billyischilly/hexydeck/Build Pictures/IMG_5169 Large.jpeg

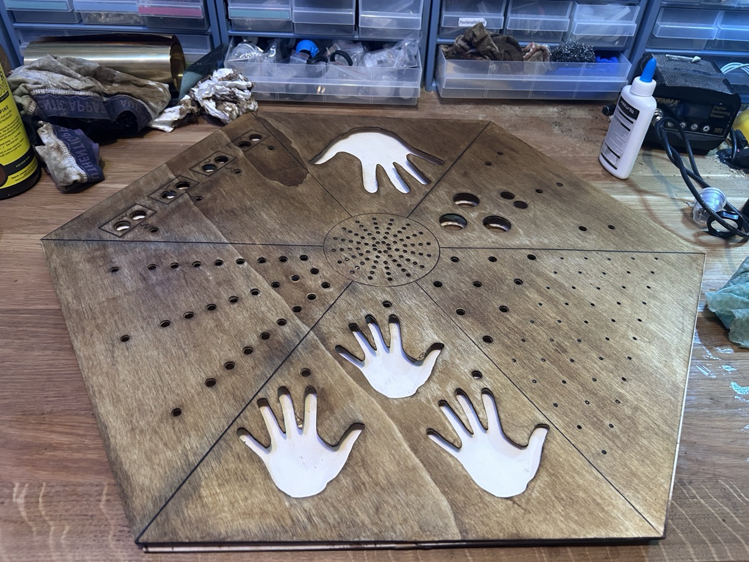
Build Pictures/IMG_5169 Large.jpeg
