billyischilly/hexydeck/Build Pictures/IMG_5170 Large.jpeg

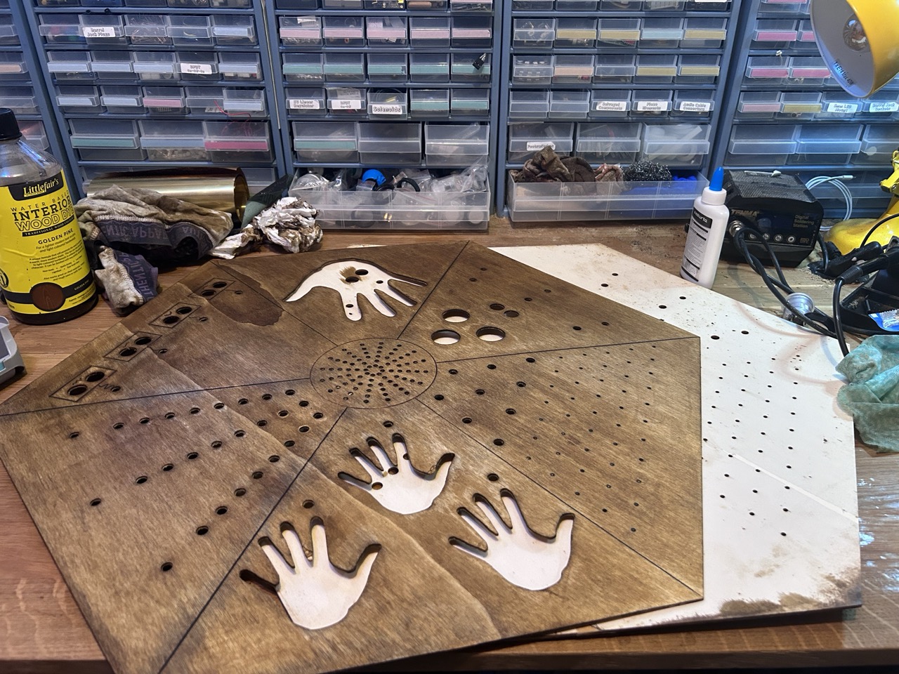
Build Pictures/IMG_5170 Large.jpeg
