billyischilly/hexydeck/Build Pictures/IMG_5171 Large.jpeg

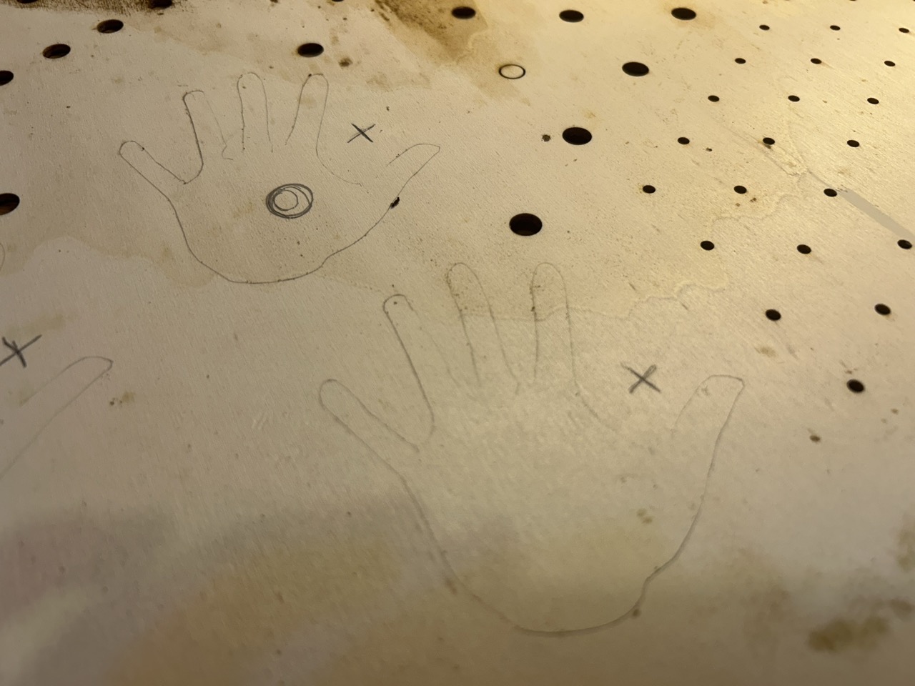
Build Pictures/IMG_5171 Large.jpeg
