billyischilly/hexydeck/Build Pictures/IMG_5172 Large.jpeg

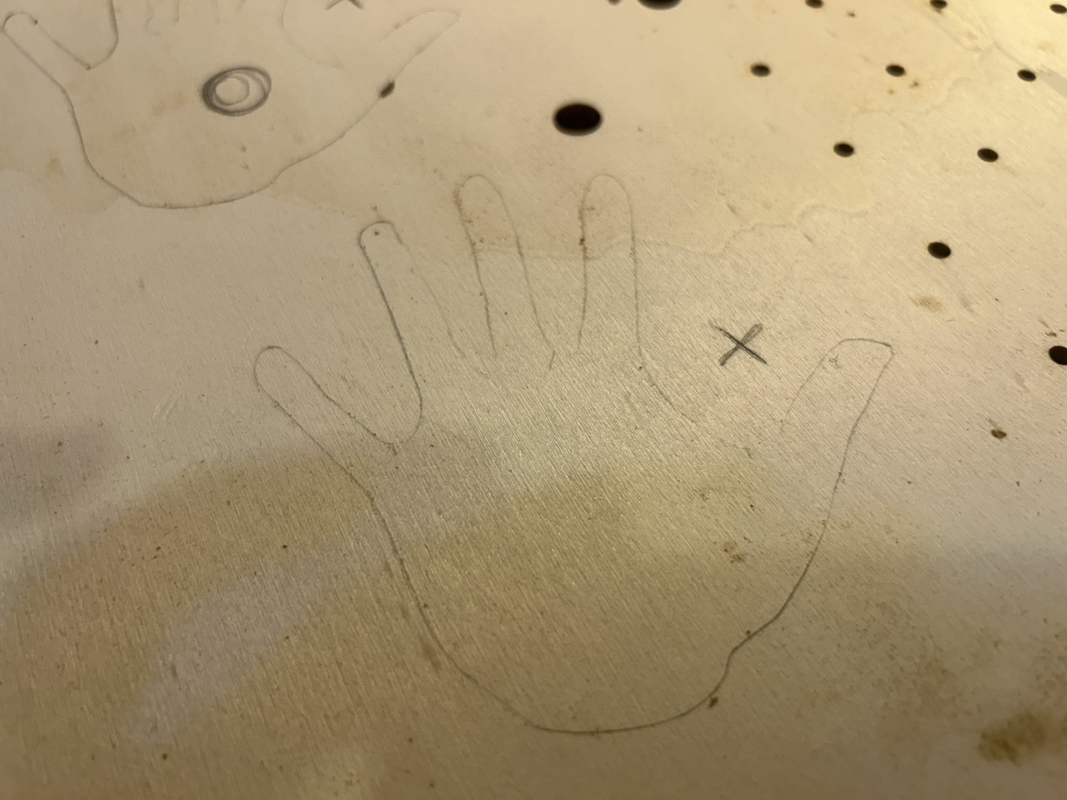
Build Pictures/IMG_5172 Large.jpeg
