billyischilly/hexydeck/Build Pictures/IMG_5173 Large.jpeg

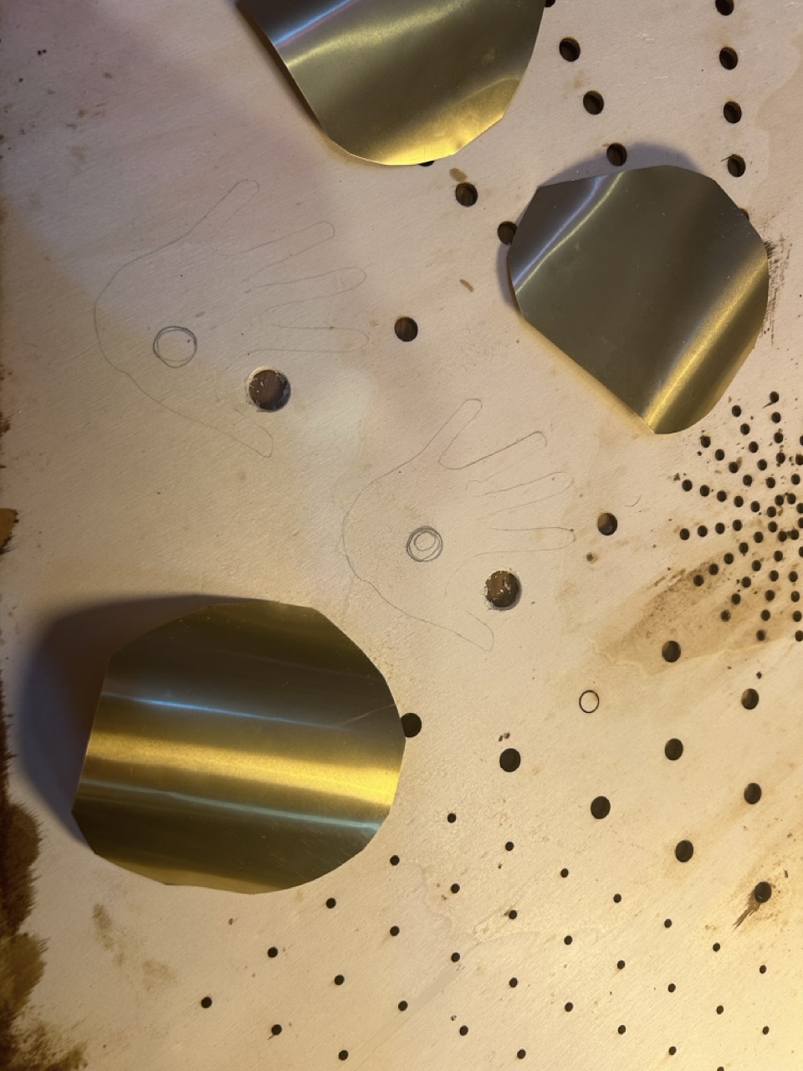
Build Pictures/IMG_5173 Large.jpeg
