billyischilly/hexydeck/Build Pictures/IMG_5174 Large.jpeg

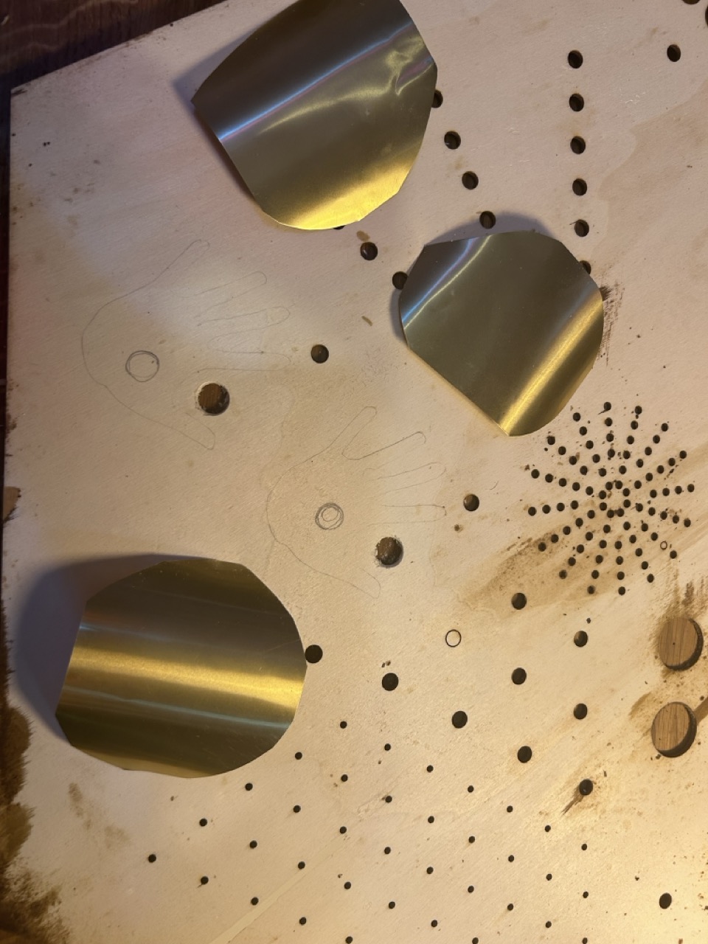
Build Pictures/IMG_5174 Large.jpeg
