billyischilly/hexydeck/Build Pictures/IMG_5175 Large.jpeg

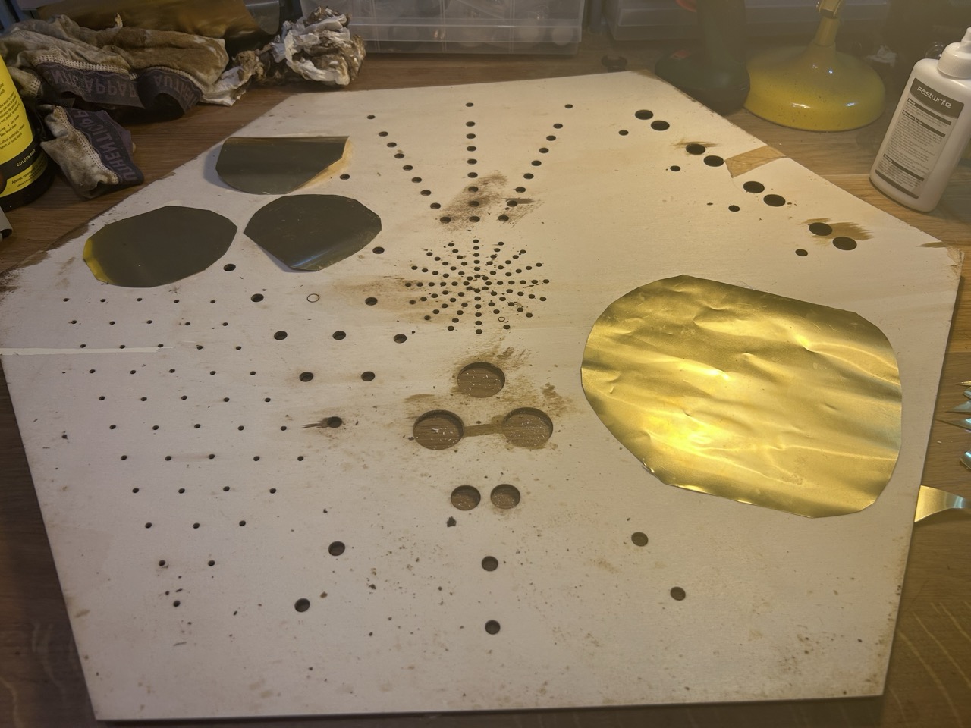
Build Pictures/IMG_5175 Large.jpeg
