billyischilly/hexydeck/Build Pictures/IMG_5176 Large.jpeg

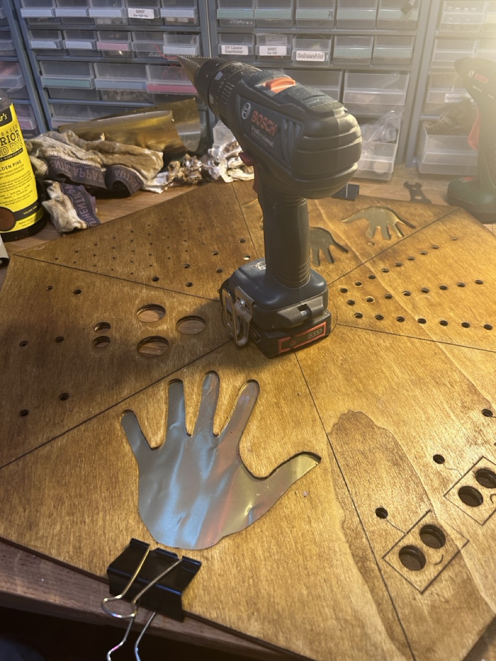
Build Pictures/IMG_5176 Large.jpeg
