billyischilly/hexydeck/Build Pictures/IMG_5178 Large.jpeg

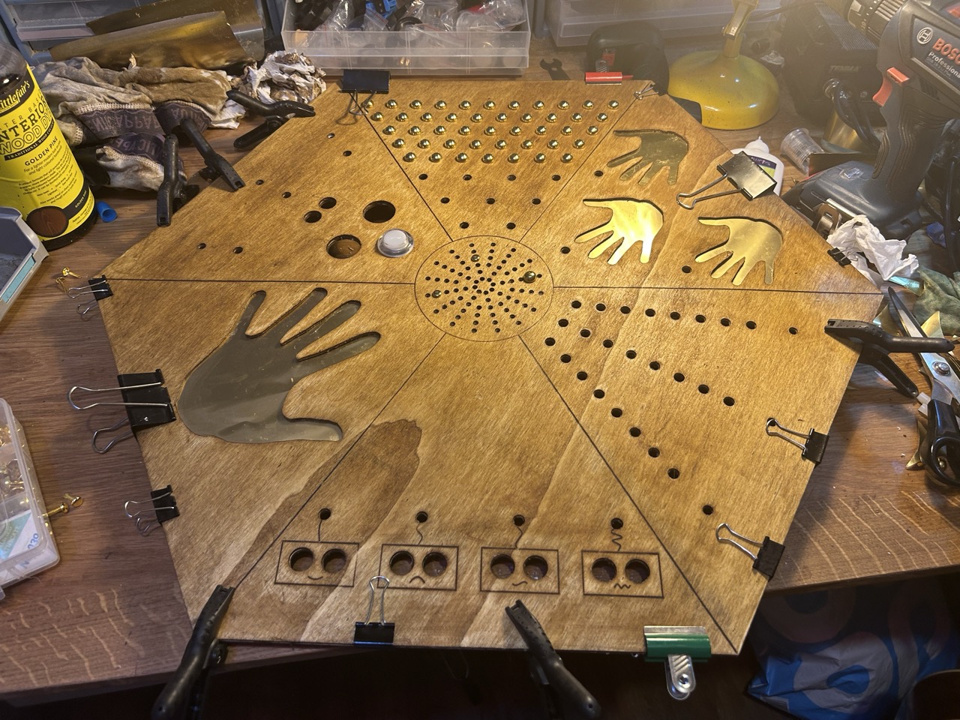
Build Pictures/IMG_5178 Large.jpeg
