billyischilly/hexydeck/Build Pictures/IMG_5283 Large.jpeg

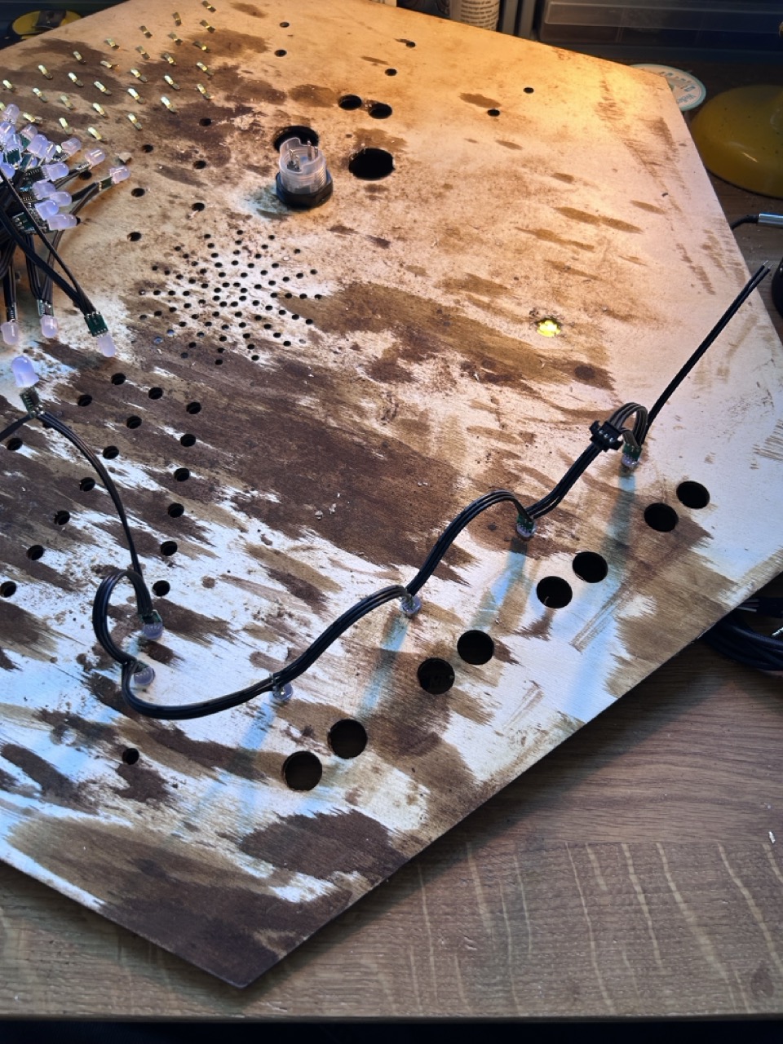
Build Pictures/IMG_5283 Large.jpeg
