billyischilly/hexydeck/Build Pictures/IMG_5284 Large.jpeg

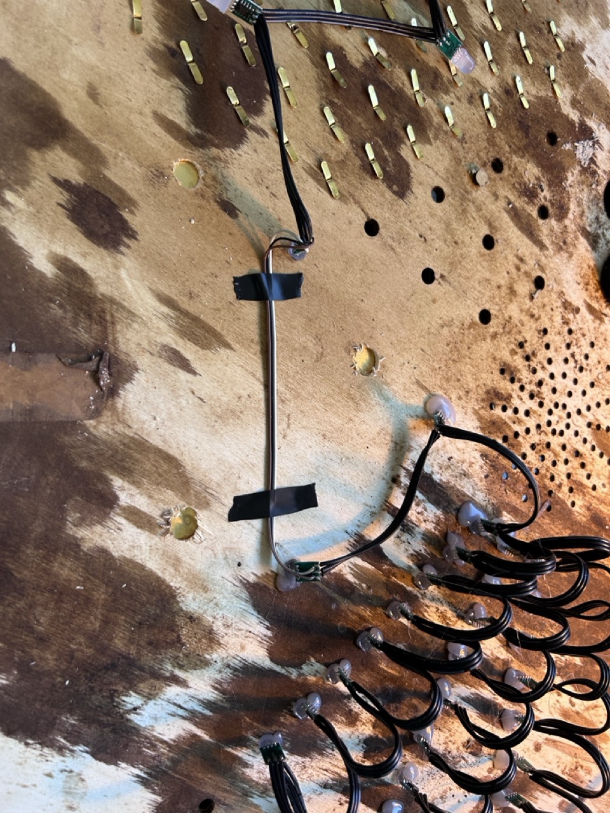
Build Pictures/IMG_5284 Large.jpeg
