billyischilly/hexydeck/Build Pictures/IMG_5285 Large.jpeg

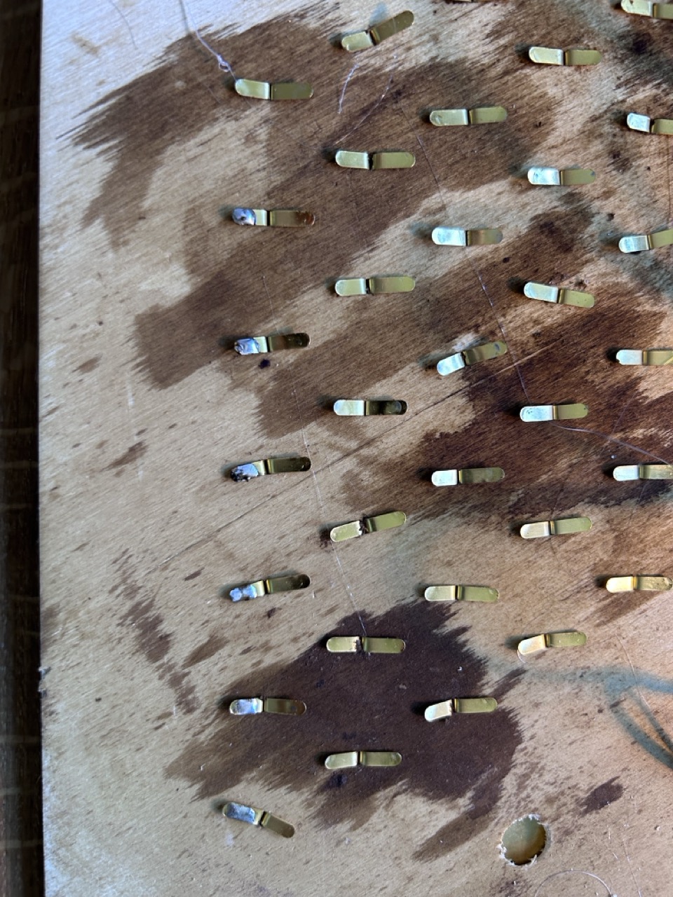
Build Pictures/IMG_5285 Large.jpeg
