billyischilly/hexydeck/Build Pictures/IMG_5286 Large.jpeg

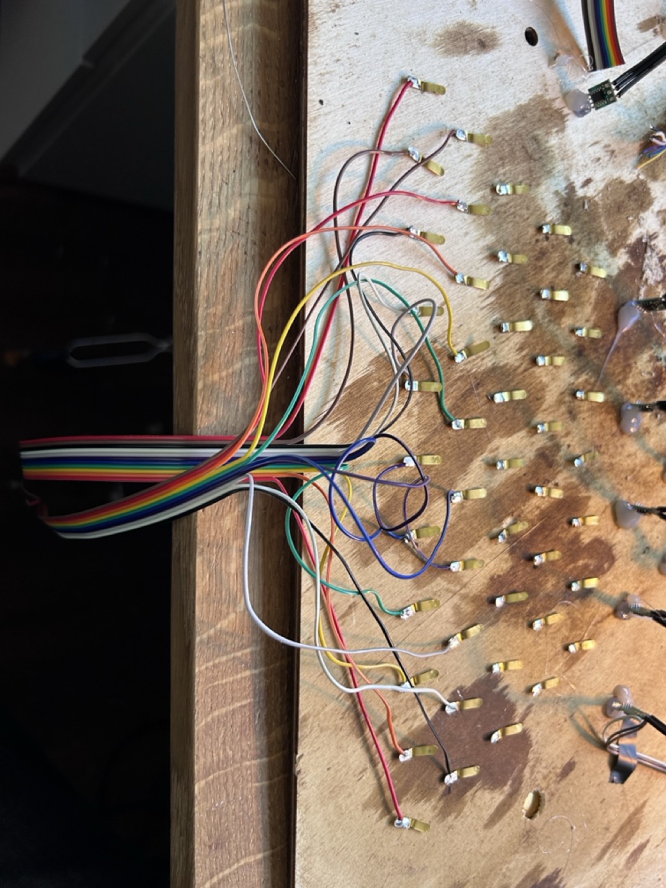
Build Pictures/IMG_5286 Large.jpeg
