billyischilly/hexydeck/Build Pictures/IMG_5295 Large.jpeg

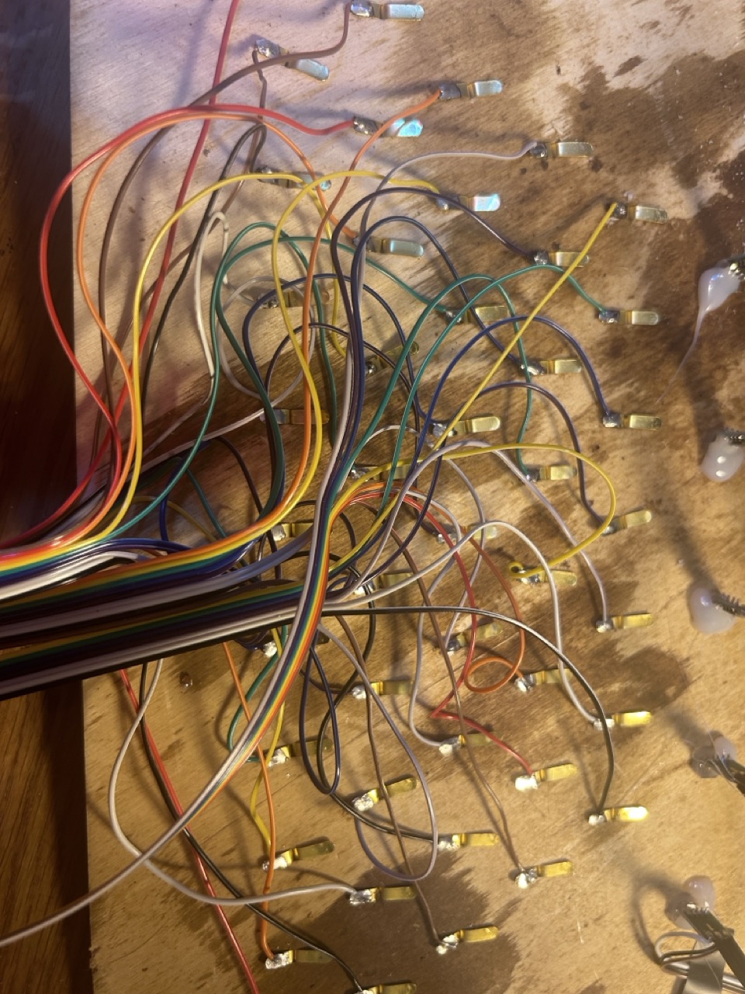
Build Pictures/IMG_5295 Large.jpeg
