billyischilly/hexydeck/Build Pictures/IMG_5296 Large.jpeg

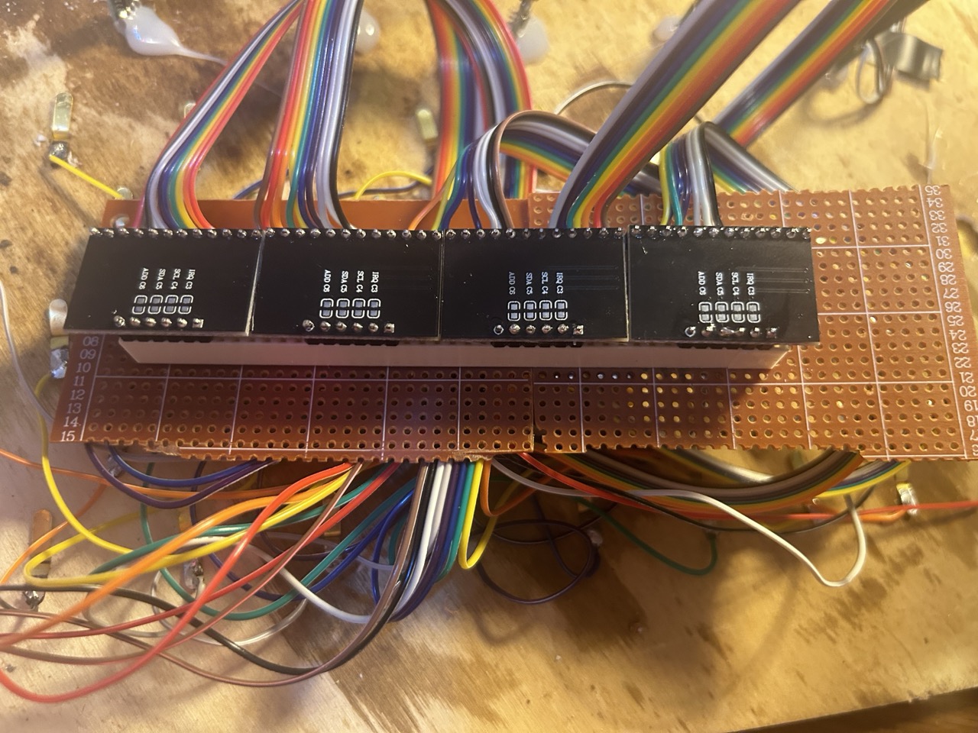
Build Pictures/IMG_5296 Large.jpeg
