billyischilly/hexydeck/Build Pictures/IMG_5302 Large.jpeg

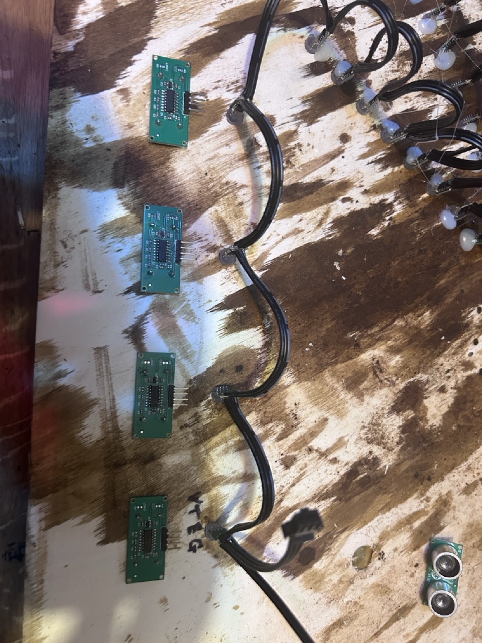
Build Pictures/IMG_5302 Large.jpeg
