billyischilly/hexydeck/Build Pictures/IMG_5316 Large.jpeg

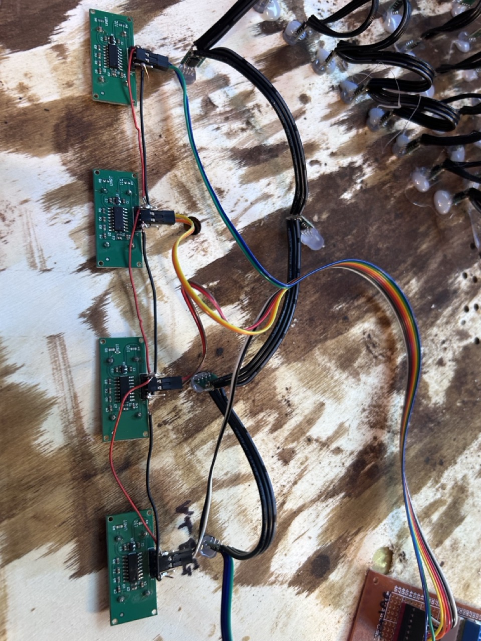
Build Pictures/IMG_5316 Large.jpeg
