billyischilly/hexydeck/Build Pictures/IMG_5317 Large.jpeg

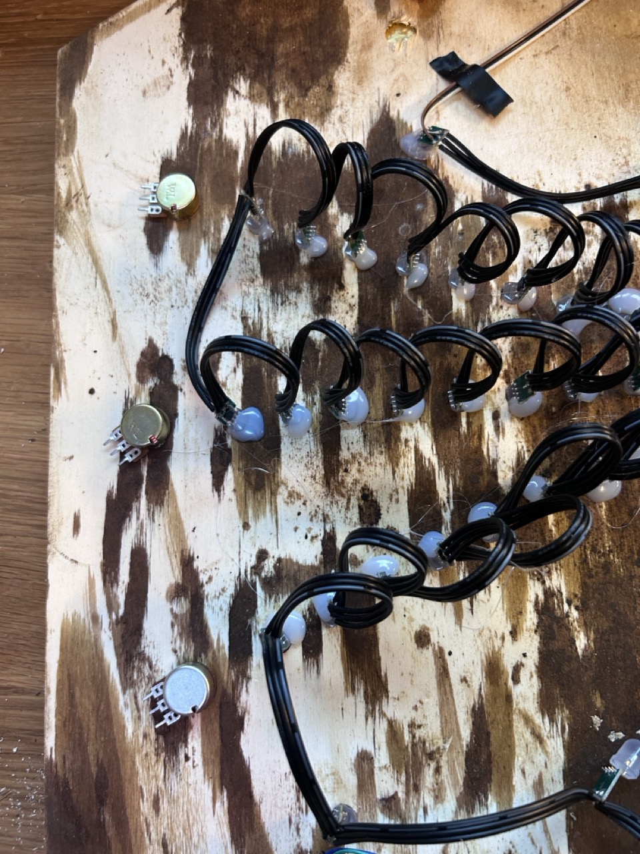
Build Pictures/IMG_5317 Large.jpeg
