billyischilly/hexydeck/Build Pictures/IMG_5322 Large.jpeg

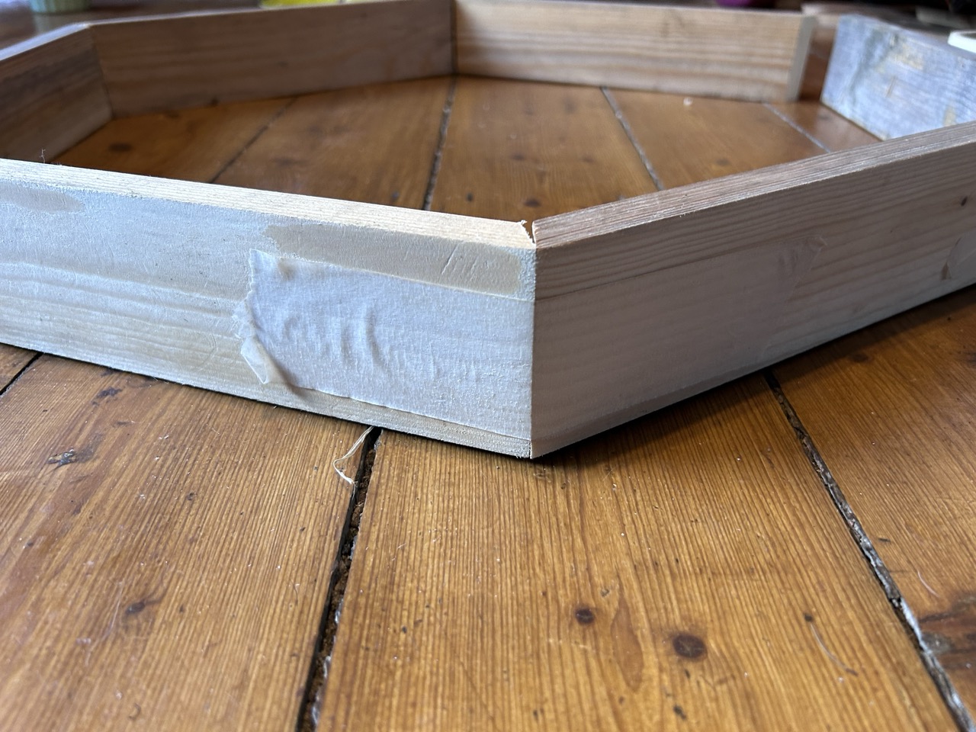
Build Pictures/IMG_5322 Large.jpeg
