billyischilly/hexydeck/Build Pictures/IMG_5323 Large.jpeg

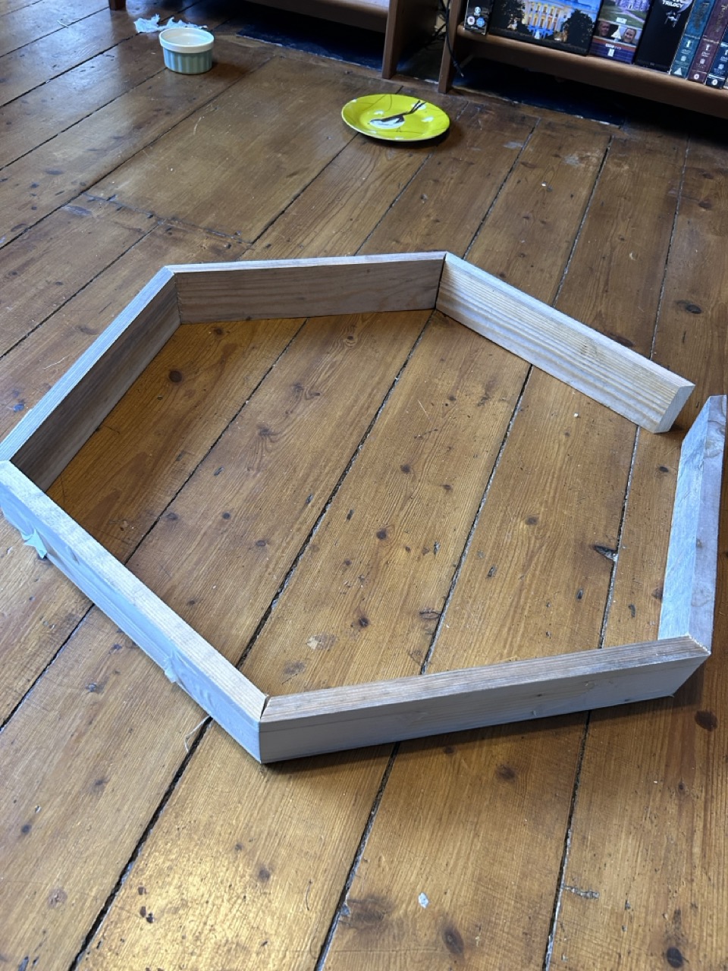
Build Pictures/IMG_5323 Large.jpeg
