billyischilly/hexydeck/Build Pictures/IMG_5324 Large.jpeg

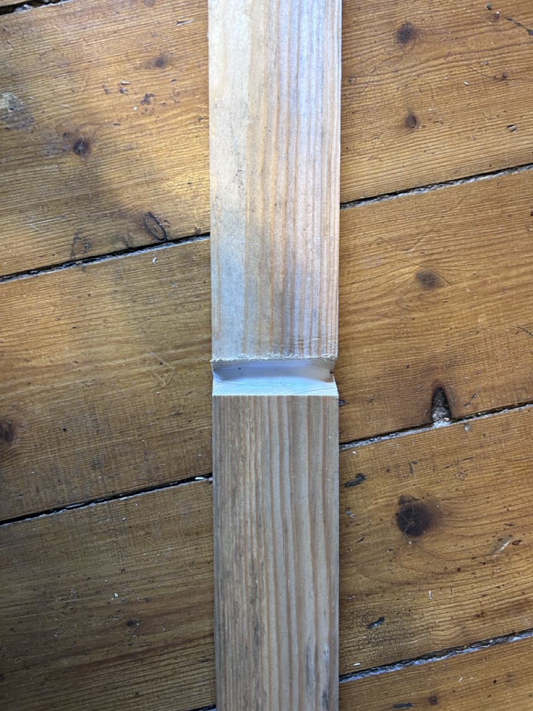
Build Pictures/IMG_5324 Large.jpeg
