billyischilly/hexydeck/Build Pictures/IMG_5325 Large.jpeg

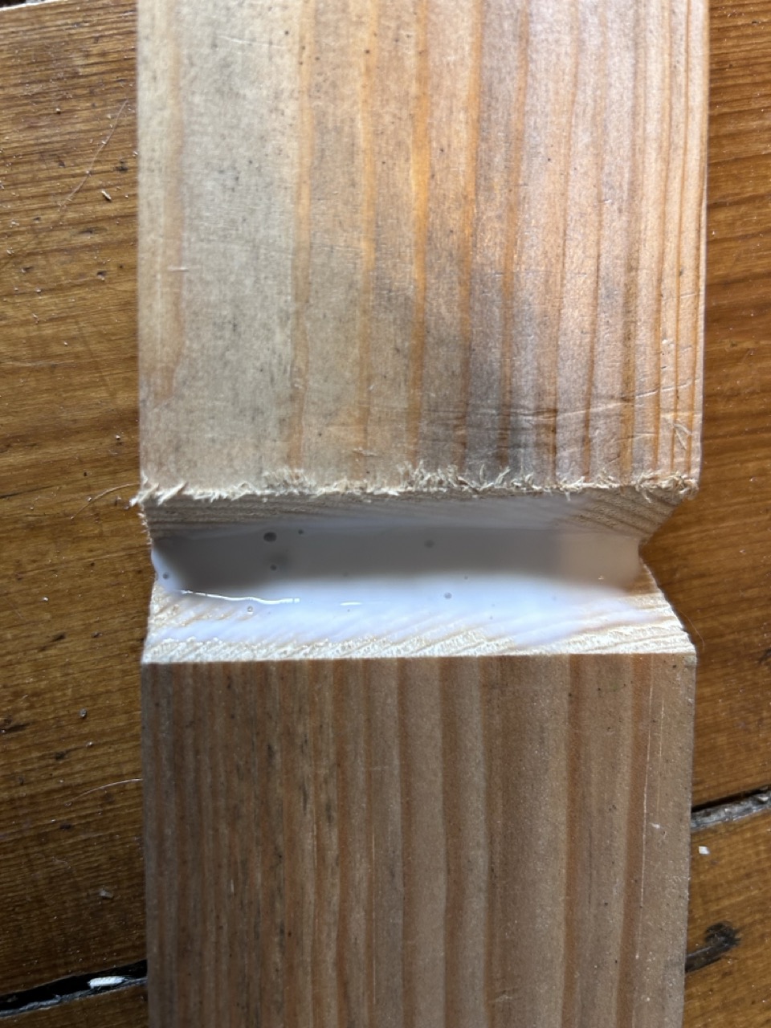
Build Pictures/IMG_5325 Large.jpeg
