billyischilly/hexydeck/Build Pictures/IMG_5326 Large.jpeg

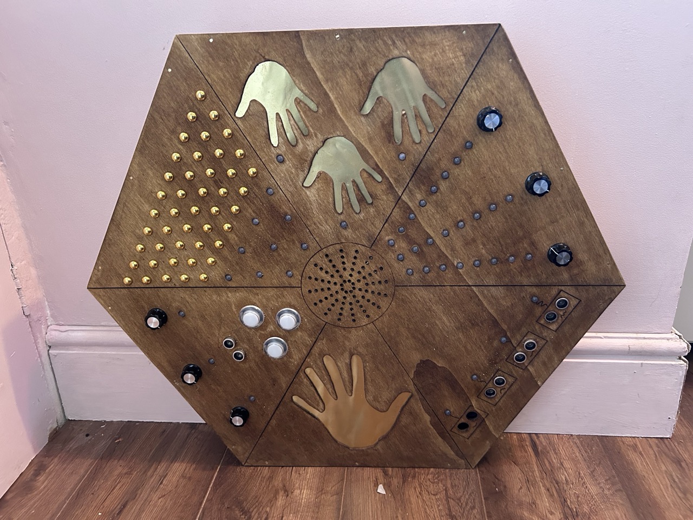
Build Pictures/IMG_5326 Large.jpeg
