billyischilly/hexydeck/Build Pictures/IMG_5327 Large.jpeg

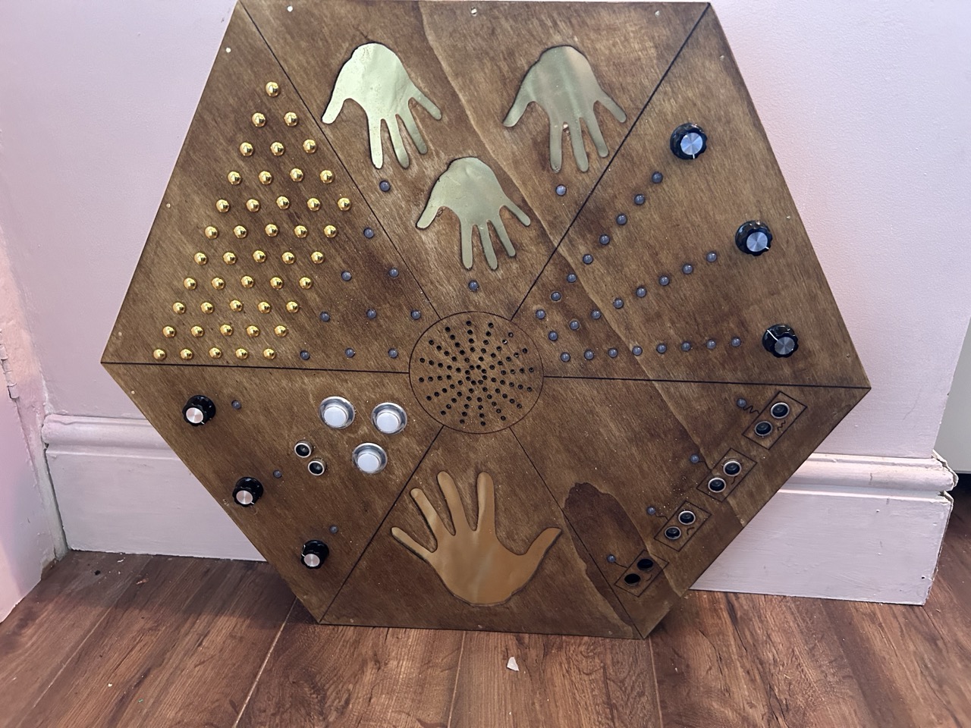
Build Pictures/IMG_5327 Large.jpeg
