billyischilly/hexydeck/Build Pictures/IMG_5328 Large.jpeg

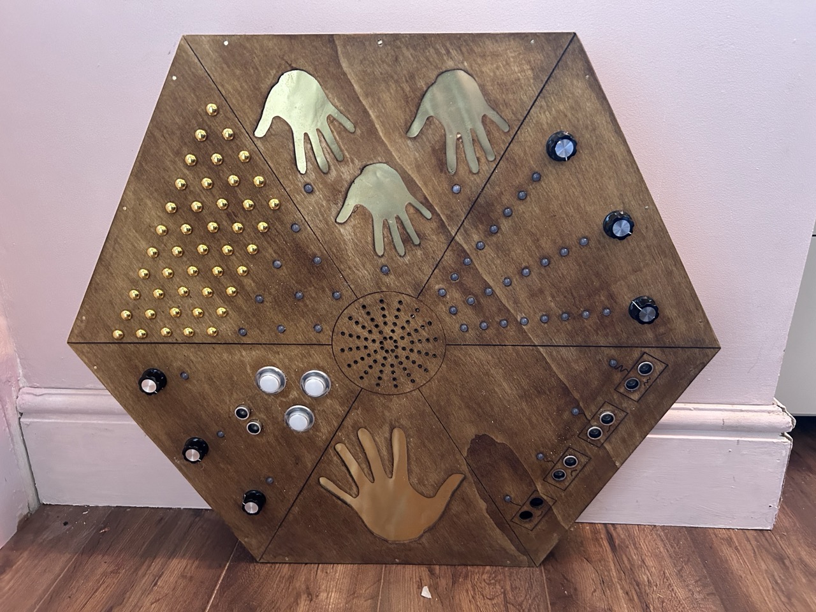
Build Pictures/IMG_5328 Large.jpeg
