billyischilly/hexydeck/Build Pictures/IMG_5342 Large.jpeg

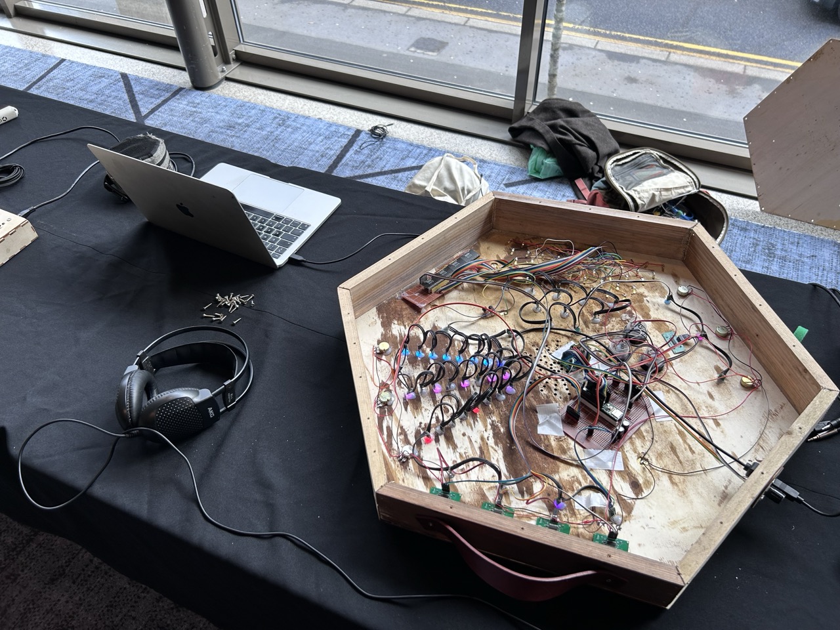
Build Pictures/IMG_5342 Large.jpeg
