billyischilly/hexydeck/Build Pictures/IMG_5343 Large.jpeg

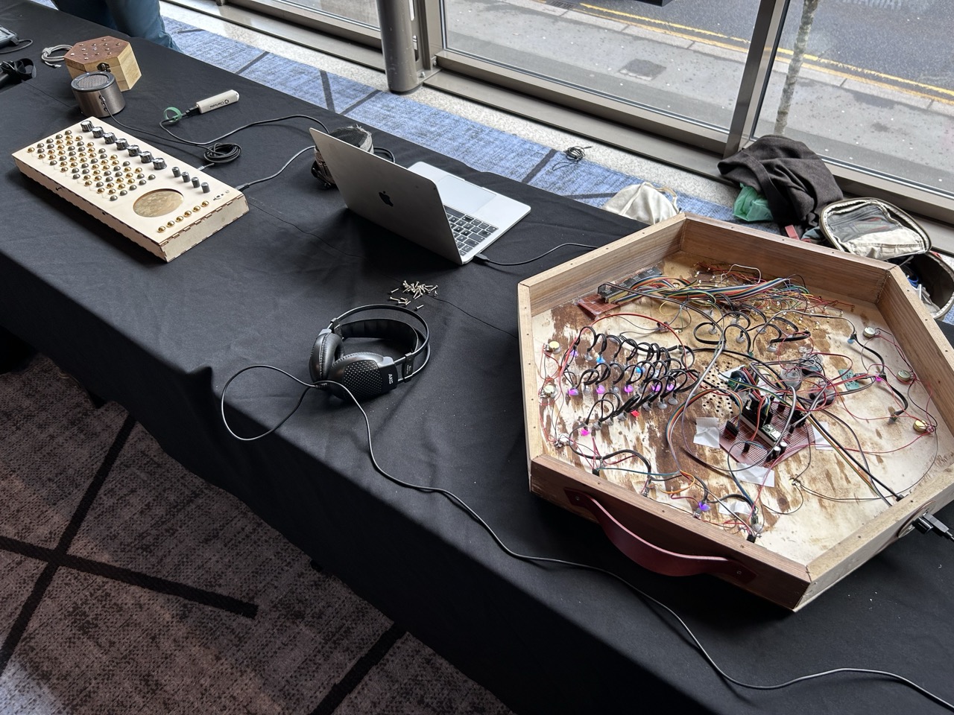
Build Pictures/IMG_5343 Large.jpeg
