billyischilly/hexydeck/Build Pictures/IMG_5347 Large.jpeg

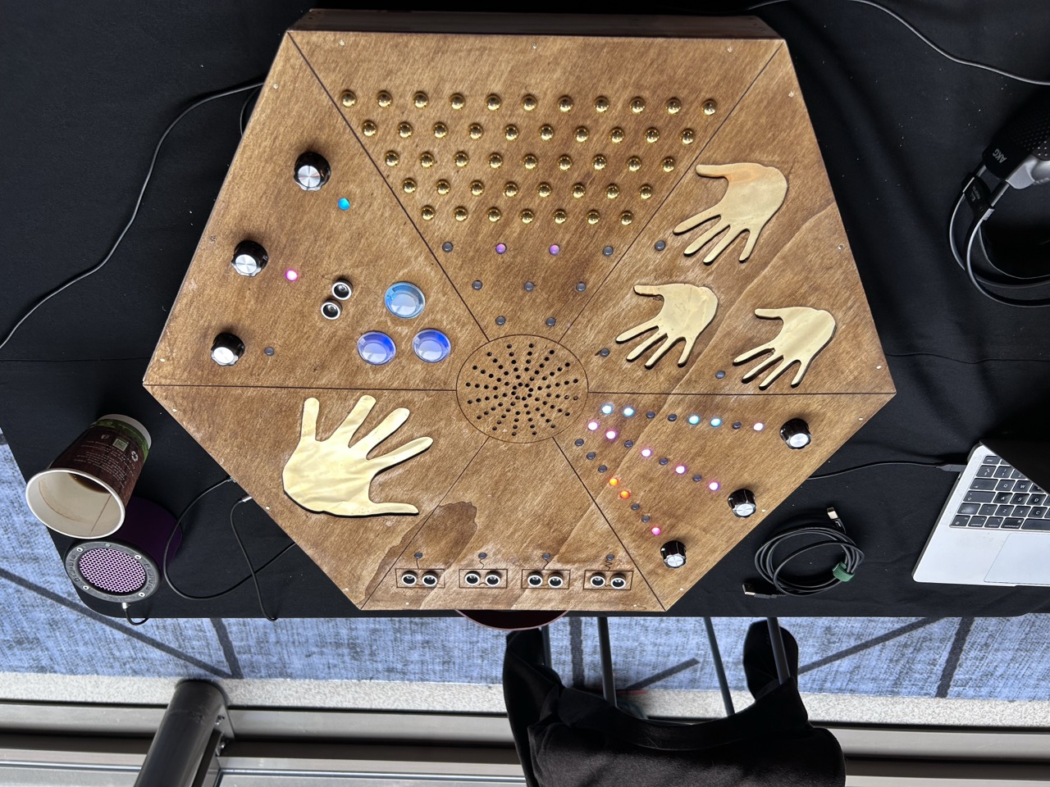
Build Pictures/IMG_5347 Large.jpeg
