billyischilly/hexydeck/Hexydeck Wiring Diagram.pdf

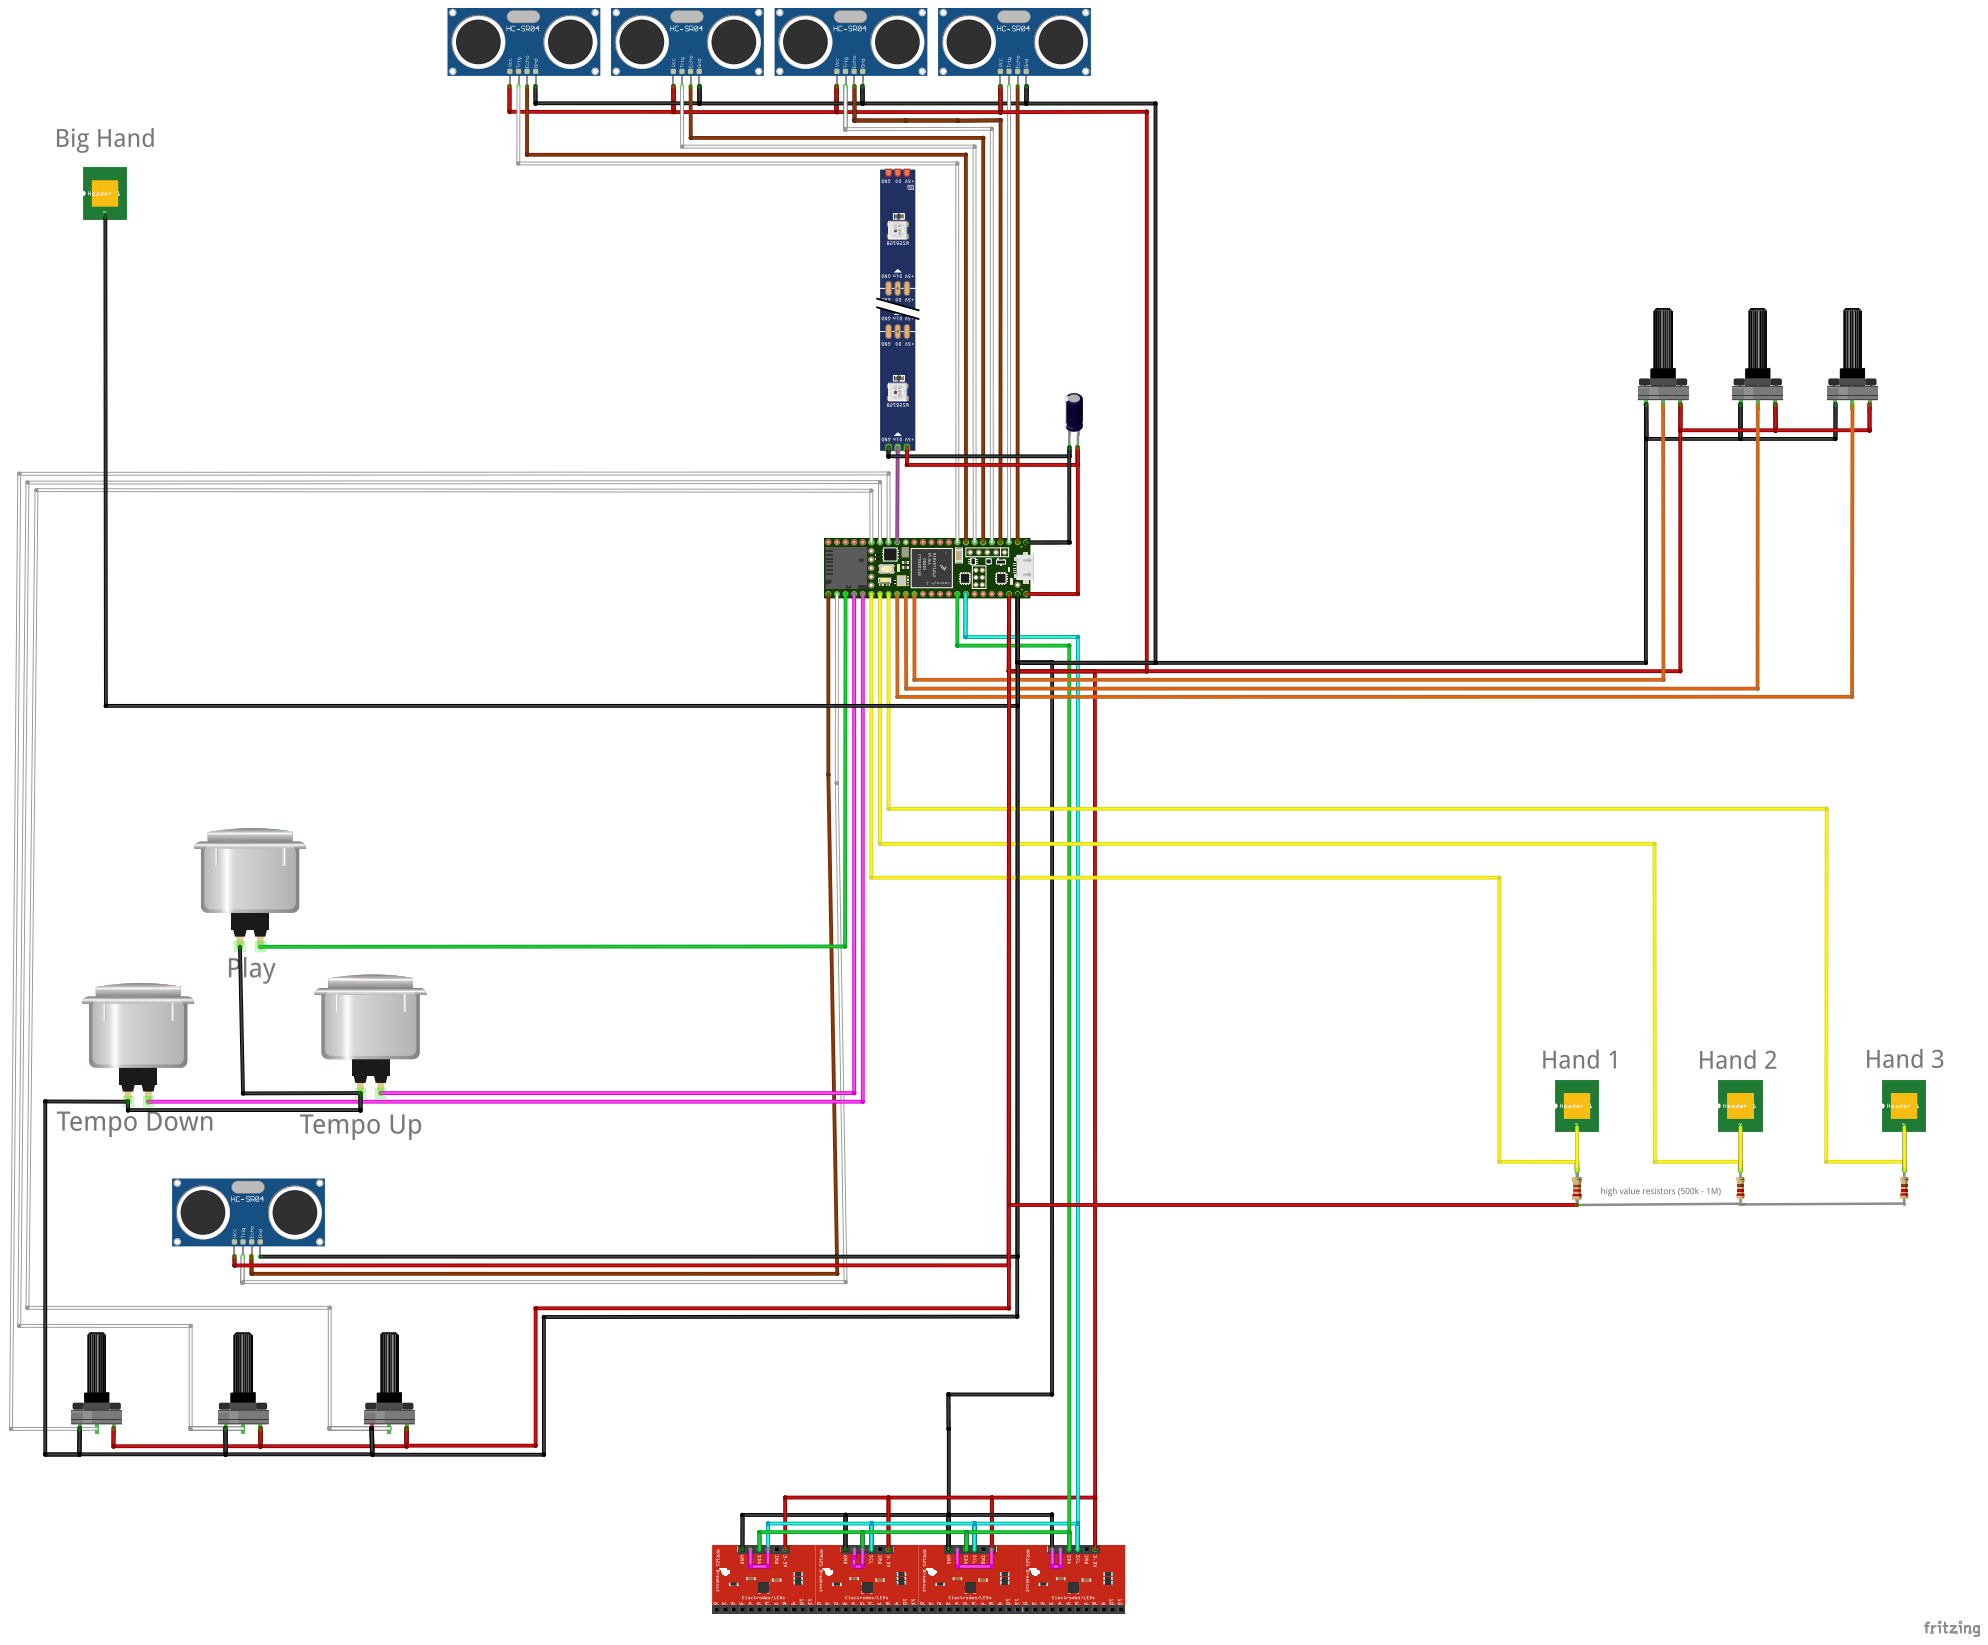
[picture p31: page 1]
