billyischilly/hexydeck/Hexydeck/drumSamples.h

PROGMEM
const unsigned int AudioSampleSnare[2465] = {
  0x01002657,
  0x80868685,
  0x47403320,
  0x5855524E,
  0x61605D5B,
  0x63636262,
  0x64646464,
  0x64646464,
  0x62626363,
  0x42515960,
  0xD8D2C319,
  0xEFEEEBE4,
  0xE7E8EBEE,
  0xE7EAEDEA,
  0xE5DEE1E5,
  0xE6E6E4E7,
  0xE8E6E3E3,
  0xE3E5E4E5,
  0xE1E2E2E1,
  0xE3E2E2E1,
  0xE5E6E4E4,
  0xE2E3E3E3,
  0xE0DBDCE1,
  0xDADEE2E1,
  0xE2D8D8DD,
  0xDEE1E0E3,
  0xCFD7DAD8,
  0xD5D6D0C5,
  0xADBDCED4,
  0xCCD0CEC3,
  0xC4D1CFC7,
  0x4309B2B4,
  0xAF19434A,
  0x513A1A90,
  0x43365057,
  0x4D52504F,
  0x55565149,
  0x5C5B5C57,
  0x5D5C5E5C,
  0x5A545861,
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
};

const unsigned int AudioSampleKick[4641] = {
  0x0100482D,
  0x94838582,
  0x36B9CCC4,
  0x67635C51,
  0x6F6E6D6A,
  0x6E6F6F6F,
  0x6C6C6D6E,
  0x696A6A6B,
  0x67676869,
  0x65666666,
  0x63646465,
  0x62626363,
  0x60606161,
  0x5D5E5F60,
  0x595A5B5C,
  0x55565758,
  0x52535455,
  0x4D4F5051,
  0x4648494B,
  0x3E414244,
  0x3134373B,
  0x101D252C,
  0xA8A29988,
  0xB8B5B2AE,
  0xC1C0BDBB,
  0xC7C5C4C3,
  0xCCCBC9C8,
  0xD0CFCECD,
  0xD2D2D1D1,
  0xD5D4D3D3,
  0xD6D6D6D5,
  0xD8D8D7D7,
  0xDADAD9D9,
  0xDCDBDBDA,
  0xDDDDDCDC,
  0xDEDEDEDD,
  0xDFDFDFDF,
  0xE0E0E0E0,
  0xE0E0E0E0,
  0xE1E1E1E1,
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
};

const unsigned int AudioSampleKickaccent[4193] = {
  0x01004174,
  0xBD028A06,
  0x5630C2CD,
  0x78757066,
  0x797A7A79,
  0x76777878,
  0x75757576,
  0x73737474,
  0x71727273,
  0x70707171,
  0x6E6F6F70,
  0x6B6C6D6D,
  0x69696A6B,
  0x66676768,
  0x63646565,
  0x60616262,
  0x5B5D5E60,
  0x5657595A,
  0x50525354,
  0x46494C4E,
  0x383D4144,
  0x12232D33,
  0xB2ABA190,
  0xC2C0BBB7,
  0xCAC8C6C4,
  0xD1D0CFCD,
  0xD5D4D3D2,
  0xD9D8D7D6,
  0xDCDBDAD9,
  0xDFDEDEDD,
  0xE1E0E0E0,
  0xE2E2E2E1,
  0xE3E3E3E3,
  0xE5E4E4E4,
  0xE6E5E5E5,
  0xE7E6E6E6,
  0xE7E7E7E7,
  0xE8E8E8E8,
  0xE9E9E9E8,
  0xE9E9E9E9,
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
};

const unsigned int AudioSampleHihataccent[609] = {
  0x01000901,
  0x1A131211,
  0x221E2018,
  0x2223241E,
  0x04261F25,
  0xE2D0C108,
  0xB8EAF1F1,
  0xEFC3726B,
  0xDF6C7B60,
  0x7262E6F2,
  0xCDEBDF62,
  0xEF4C6B5A,
  0x4A705DE6,
  0x4946D9E7,
  0xCF3E441B,
  0x455D33D8,
  0x30D1D4C8,
  0xEEE36367,
  0xC96866BE,
  0x605BD0EC,
  0xD3E3D151,
  0xE31B655C,
  0x486350D9,
  0x383ED5E0,
  0xD7D84C4A,
  0xE3316156,
  0x4D6353DD,
  0x5606E1DF,
  0xEAE74D63,
  0xE458714E,
  0x5E60C3E6,
  0x44D1D7AA,
  0xB2B60E50,
  0x254922C1,
  0x4D34C9C1,
  0xCEC2102B,
  0xD0155230,
  0xC23444AF,
  0x4F5830C7,
  0x6523E3D9,
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
};
